robertgregor/wDuino/eagleFiles/wDuino.brd

## EAGLE design eagleFiles/wDuino.brd (2015-03-09)

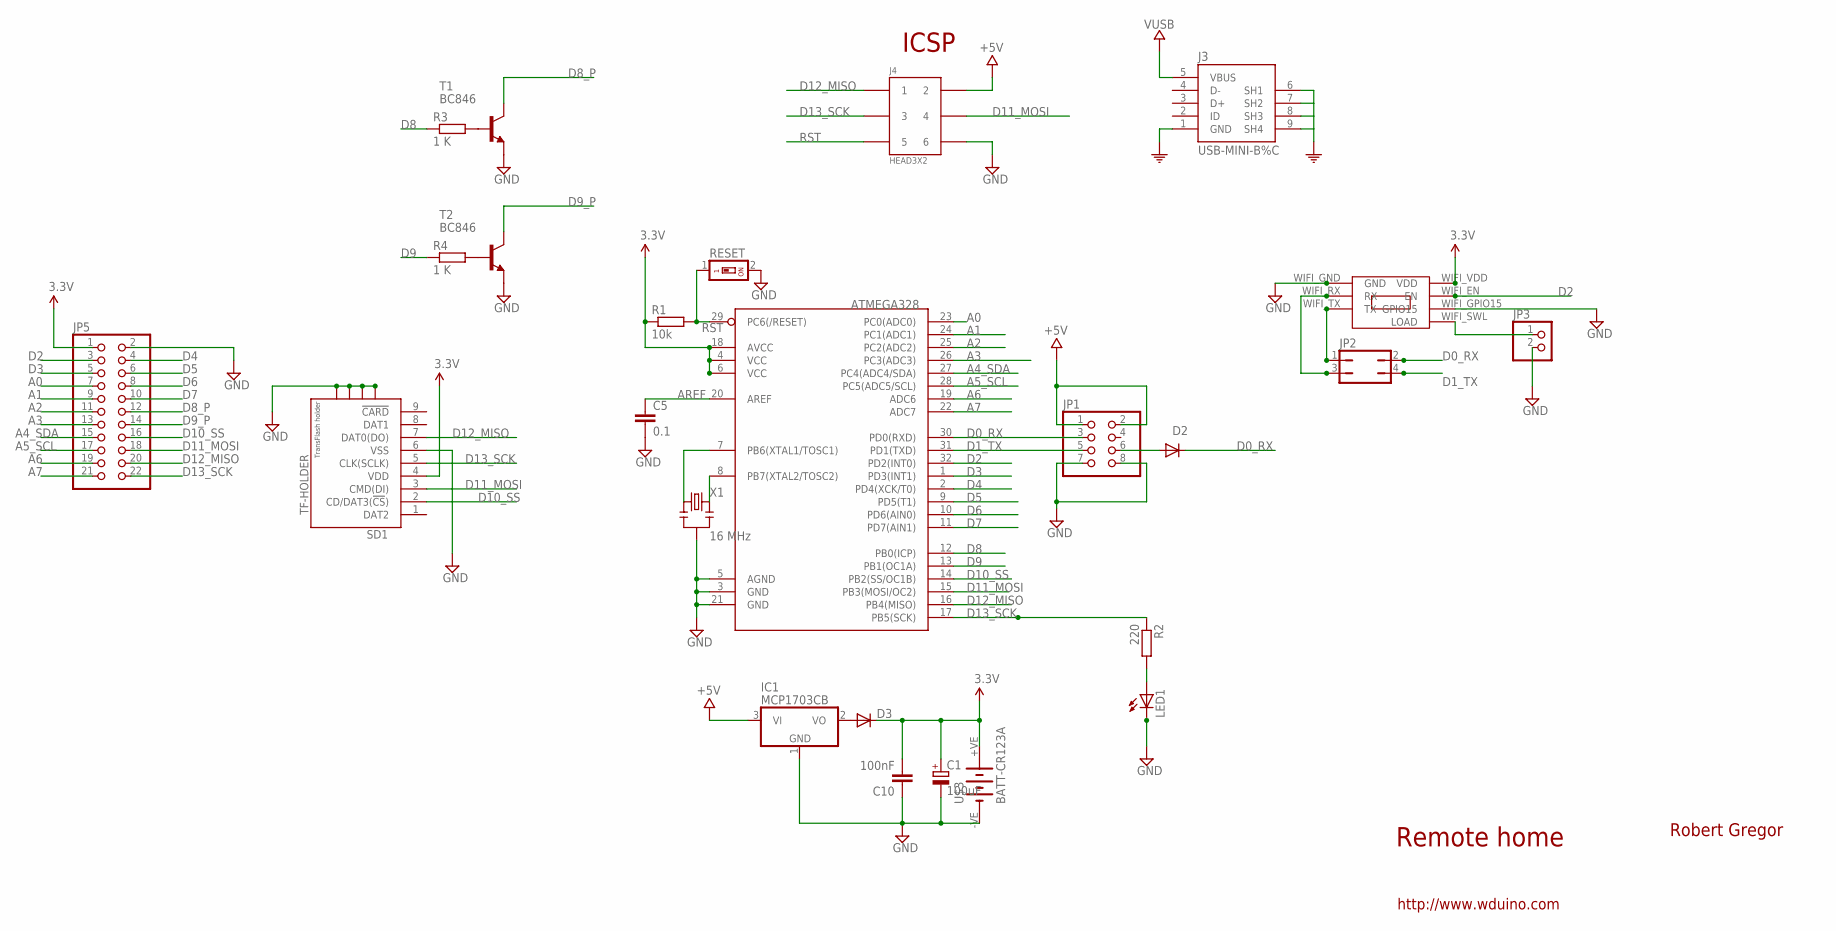
[picture p1: schematic wDuino.sch]

Parts:
ATMEGA328: ATMega-328; TQFP32-08
C1: 100uF; SMC_B
C5: 0.1; C0603
C10: 100nF; C0603
D2: DIODE-SOD123; SOD123
D3: DIODE-DO214AC; DO214AC
IC1: MCP1703CB; SOT23
J3: USB-MINI-B%C; USB-MINI-B_2
J4: HEAD3X2
JP1: PINHD-2X4; 2X04
JP2: JP2Q
JP3: PINHD-1X2; 1X02
JP5: PINHD-2X11; 2X11
LED1: LEDSML0603; SML0603
R1: 10k; R0603
R2: 220; R0603
R3, R4: 1 K; R0603
RESET: SWS001; SMS-001
SD1: TF-HOLDER; TF-PULL
T1, T2: BC846; SOT23
U$3: BATT-CR123A; KEYSTONE-2/3A
U$5: ESP03
X1: 16 MHz; RESONATOR-SMD

Connections:
5V: IC1.3 (VI), J3.5 (VBUS), J4.2, JP1.1, JP1.2
A0: ATMEGA328.23 (PC0(ADC0)), JP5.7
A1: ATMEGA328.24 (PC1(ADC1)), JP5.9
A2: ATMEGA328.25 (PC2(ADC2)), JP5.11
A3: ATMEGA328.26 (PC3(ADC3)), JP5.13
A4_SDA: ATMEGA328.27 (PC4(ADC4/SDA)), JP5.15
A5_SCL: ATMEGA328.28 (PC5(ADC5/SCL)), JP5.17
A6: ATMEGA328.19 (ADC6), JP5.19
A7: ATMEGA328.22 (ADC7), JP5.21
AREF: ATMEGA328.20 (AREF), C5.1
D0_RX: ATMEGA328.30 (PD0(RXD)), D2.C, JP1.3, JP2.2
D1_TX: ATMEGA328.31 (PD1(TXD)), JP1.5, JP2.4
D2: ATMEGA328.32 (PD2(INT0)), JP5.3, U$5.WIFI_EN (EN)
D3: ATMEGA328.1 (PD3(INT1)), JP5.5
D4: ATMEGA328.2 (PD4(XCK/T0)), JP5.4
D5: ATMEGA328.9 (PD5(T1)), JP5.6
D6: ATMEGA328.10 (PD6(AIN0)), JP5.8
D7: ATMEGA328.11 (PD7(AIN1)), JP5.10
D8: ATMEGA328.12 (PB0(ICP)), R3.1
D8_P: JP5.12, T1.3 (C)
D9: ATMEGA328.13 (PB1(OC1A)), R4.1
D9_P: JP5.14, T2.3 (C)
D10_SS: ATMEGA328.14 (PB2(SS/OC1B)), JP5.16, SD1.2 (CD/DAT3(!CS!))
D11_MOSI: ATMEGA328.15 (PB3(MOSI/OC2)), J4.4, JP5.18, SD1.3 (CMD(DI))
D12_MISO: ATMEGA328.16 (PB4(MISO)), J4.1, JP5.20, SD1.7 (DAT0(DO))
D13_SCK: ATMEGA328.17 (PB5(SCK)), J4.3, JP5.22, R2.1, SD1.5 (CLK(SCLK))
GND: ATMEGA328.3 (GND), ATMEGA328.5 (AGND), ATMEGA328.21 (GND), C1.-, C5.2, C10.1, IC1.1 (GND), J3.1 (GND), J3.6 (SH1), J3.7 (SH2), J3.8 (SH3), J3.9 (SH4), J4.6, JP1.7, JP1.8, JP3.2, JP5.2, LED1.C, RESET.2, SD1.6 (VSS), SD1.S1, SD1.S2, SD1.S3, SD1.S4, T1.2 (E), T2.2 (E), U$3.-VE (-), U$5.WIFI_GND (GND), U$5.WIFI_GPIO15 (GPIO15), X1.2
unnamed: ATMEGA328.7 (PB6(XTAL1/TOSC1)), X1.1
unnamed: D3.A, IC1.2 (VO)
unnamed: LED1.A, R2.2
unnamed: JP3.1, U$5.WIFI_SWL (LOAD)
unnamed: R4.2, T2.1 (B)
unnamed: D2.A, JP1.6
unnamed: R3.2, T1.1 (B)
unnamed: JP2.1, U$5.WIFI_TX (TX)
unnamed: JP2.3, U$5.WIFI_RX (RX)
unnamed: ATMEGA328.8 (PB7(XTAL2/TOSC2)), X1.3
RST: ATMEGA328.29 (PC6(/RESET)), J4.5, R1.2, RESET.1
VCC: ATMEGA328.4 (VCC), ATMEGA328.6 (VCC), ATMEGA328.18 (AVCC), C1.+, C10.2, D3.C, JP5.1, R1.1, SD1.4 (VDD), U$3.+VE (+), U$5.WIFI_VDD (VDD)

Notes on the sheet:
Remote home
Robert Gregor
http://www.wduino.com
ICSP

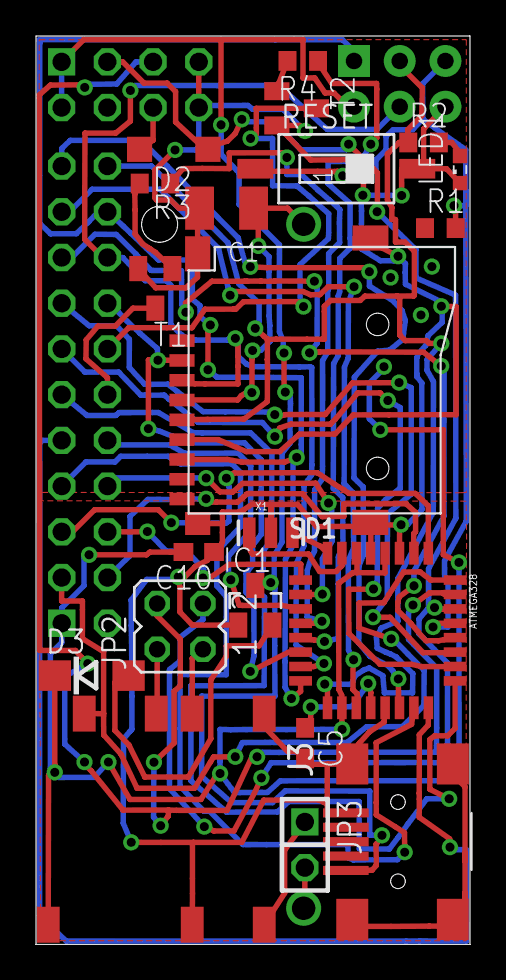
[picture p2: board eagleFiles/wDuino.brd from above]

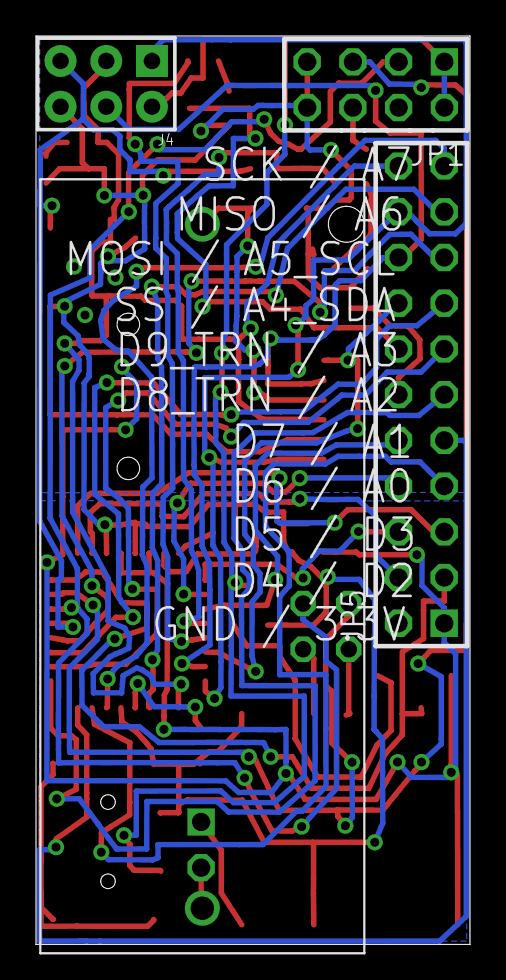
[picture p3: board eagleFiles/wDuino.brd from below]

Board: 2 copper layers, 24.1 x 50.5 mm, 25 parts (4 on the bottom side), 39 nets.
