robertgregor/wDuino/eagleFiles/itead/wDuino.brd

## EAGLE design eagleFiles/itead/wDuino.brd (2015-03-09)

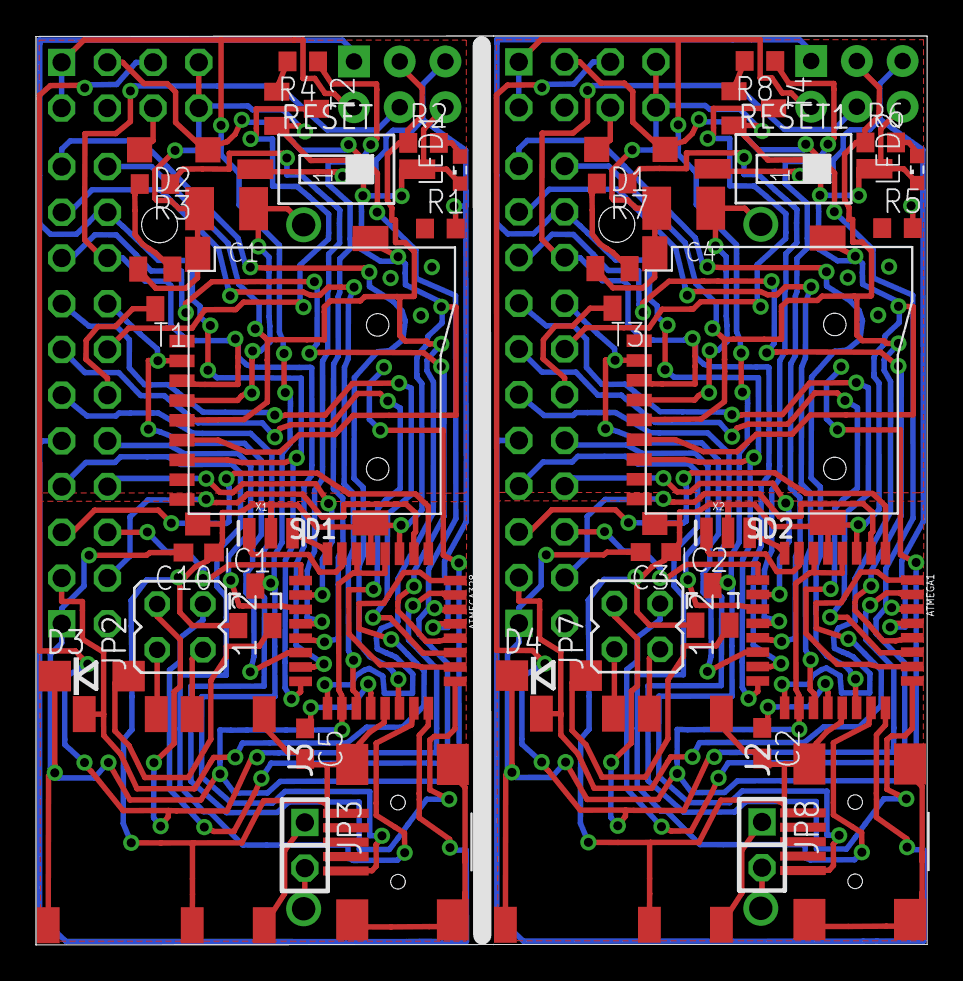
[picture p4: board eagleFiles/itead/wDuino.brd from above]

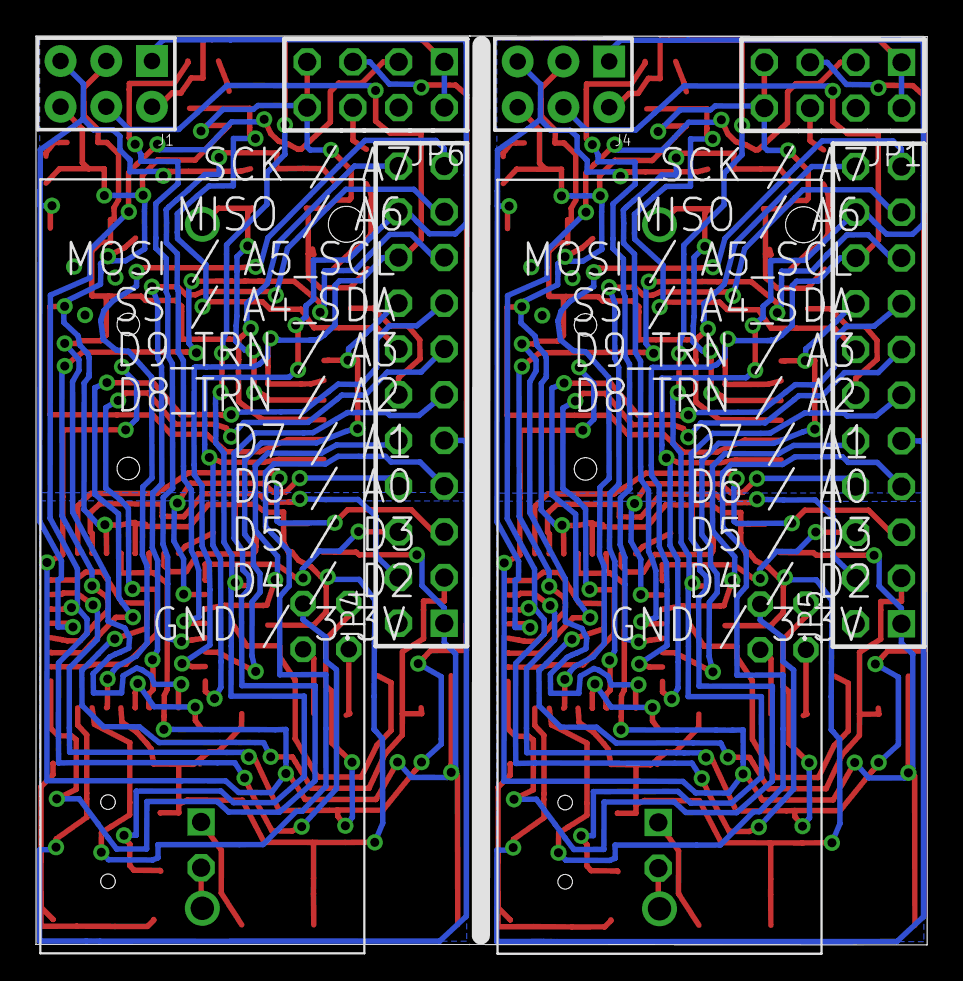
[picture p5: board eagleFiles/itead/wDuino.brd from below]

Board: 2 copper layers, 49.5 x 50.5 mm, 50 parts (8 on the bottom side), 78 nets.

Parts:
ATMEGA1, ATMEGA328: ATMega-328; TQFP32-08
C1, C4: 100uF; SMC_B
C2, C5: 0.1; C0603
C3, C10: 100nF; C0603
D1, D2: SOD123
D3, D4: DO214AC
IC1, IC2: MCP1703CB; SOT23
J1, J4: HEAD3X2
J2, J3: USB-MINI-B%C; USB-MINI-B_2
JP1, JP6: 2X04
JP2, JP7: JP2Q
JP3, JP8: 1X02
JP4, JP5: 2X11
LED1, LED2: SML0603
R1, R5: 10k; R0603
R2, R6: 220; R0603
R3, R4, R7, R8: 1 K; R0603
RESET, RESET1: SMS-001
SD1, SD2: TF-HOLDER; TF-PULL
T1, T2, T3, T4: BC846; SOT23
U$1, U$3: BATT-CR123A; KEYSTONE-2/3A
U$2, U$5: ESP03
X1, X2: 16 MHz; RESONATOR-SMD

Connections:
5V: IC1.3, J3.5, J4.2, JP1.1, JP1.2
5V1: IC2.3, J1.2, J2.5, JP6.1, JP6.2
A0: ATMEGA328.23, JP5.7
A1: ATMEGA328.24, JP5.9
A2: ATMEGA328.25, JP5.11
A3: ATMEGA328.26, JP5.13
A4: ATMEGA1.22, JP4.21
A4_SDA: ATMEGA328.27, JP5.15
A4_SDA1: ATMEGA1.27, JP4.15
A5: ATMEGA1.19, JP4.19
A5_SCL: ATMEGA328.28, JP5.17
A5_SCL1: ATMEGA1.28, JP4.17
A6: ATMEGA328.19, JP5.19
A7: ATMEGA328.22, JP5.21
A8: ATMEGA1.26, JP4.13
A9: ATMEGA1.25, JP4.11
A10: ATMEGA1.24, JP4.9
A11: ATMEGA1.23, JP4.7
AREF: ATMEGA328.20, C5.1
AREF1: ATMEGA1.20, C2.1
D0_RX: ATMEGA328.30, D2.C, JP1.3, JP2.2
D0_RX1: ATMEGA1.30, D1.C, JP6.3, JP7.2
D1: ATMEGA1.13, R8.1
D1_TX: ATMEGA328.31, JP1.5, JP2.4
D1_TX1: ATMEGA1.31, JP6.5, JP7.4
D2: ATMEGA328.32, JP5.3, U$5.WIFI_EN
D3: ATMEGA328.1, JP5.5
D4: ATMEGA328.2, JP5.4
D5: ATMEGA328.9, JP5.6
D6: ATMEGA328.10, JP5.8
D7: ATMEGA328.11, JP5.10
D8: ATMEGA328.12, R3.1
D8_P: JP5.12, T1.3
D8_P1: JP4.12, T3.3
D9: ATMEGA328.13, R4.1
D9_P: JP5.14, T2.3
D9_P1: JP4.14, T4.3
D10: ATMEGA1.12, R7.1
D10_SS: ATMEGA328.14, JP5.16, SD1.2
D10_SS1: ATMEGA1.14, JP4.16, SD2.2
D11: ATMEGA1.11, JP4.10
D11_MOSI: ATMEGA328.15, J4.4, JP5.18, SD1.3
D11_MOSI1: ATMEGA1.15, J1.4, JP4.18, SD2.3
D12: ATMEGA1.10, JP4.8
D12_MISO: ATMEGA328.16, J4.1, JP5.20, SD1.7
D12_MISO1: ATMEGA1.16, J1.1, JP4.20, SD2.7
D13: ATMEGA1.9, JP4.6
D13_SCK: ATMEGA328.17, J4.3, JP5.22, R2.1, SD1.5
D13_SCK1: ATMEGA1.17, J1.3, JP4.22, R6.1, SD2.5
D14: ATMEGA1.2, JP4.4
D15: ATMEGA1.1, JP4.5
D16: ATMEGA1.32, JP4.3, U$2.WIFI_EN
GND: ATMEGA328.3, ATMEGA328.5, ATMEGA328.21, C1.-, C5.2, C10.1, IC1.1, J3.1, J3.6, J3.7, J3.8, J3.9, J4.6, JP1.7, JP1.8, JP3.2, JP5.2, LED1.C, RESET.2, SD1.6, SD1.S1, SD1.S2, SD1.S3, SD1.S4, T1.2, T2.2, U$3.-VE, U$5.WIFI_GND, U$5.WIFI_GPIO15, X1.2
GND1: ATMEGA1.3, ATMEGA1.5, ATMEGA1.21, C2.2, C3.1, C4.-, IC2.1, J1.6, J2.1, J2.6, J2.7, J2.8, J2.9, JP4.2, JP6.7, JP6.8, JP8.2, LED2.C, RESET1.2, SD2.6, SD2.S1, SD2.S2, SD2.S3, SD2.S4, T3.2, T4.2, U$1.-VE, U$2.WIFI_GND, U$2.WIFI_GPIO15, X2.2
unnamed: ATMEGA328.7, X1.1
unnamed: D3.A, IC1.2
unnamed: ATMEGA1.7, X2.1
unnamed: LED1.A, R2.2
unnamed: JP3.1, U$5.WIFI_SWL
unnamed: R4.2, T2.1
unnamed: D2.A, JP1.6
unnamed: R3.2, T1.1
unnamed: ATMEGA1.8, X2.3
unnamed: JP2.1, U$5.WIFI_TX
unnamed: JP2.3, U$5.WIFI_RX
unnamed: JP7.1, U$2.WIFI_TX
unnamed: JP7.3, U$2.WIFI_RX
unnamed: LED2.A, R6.2
unnamed: D1.A, JP6.6
unnamed: R7.2, T3.1
unnamed: R8.2, T4.1
unnamed: D4.A, IC2.2
unnamed: JP8.1, U$2.WIFI_SWL
unnamed: ATMEGA328.8, X1.3
RST: ATMEGA328.29, J4.5, R1.2, RESET.1
RST1: ATMEGA1.29, J1.5, R5.2, RESET1.1
VCC: ATMEGA328.4, ATMEGA328.6, ATMEGA328.18, C1.+, C10.2, D3.C, JP5.1, R1.1, SD1.4, U$3.+VE, U$5.WIFI_VDD
VCC1: ATMEGA1.4, ATMEGA1.6, ATMEGA1.18, C3.2, C4.+, D4.C, JP4.1, R5.1, SD2.4, U$1.+VE, U$2.WIFI_VDD
