robertgregor/wDuino/(notices)

Notices in the files:
SketchLoader_Java/Java/src/main/java/org/remoteHome/stk500_v1/ConstantsStk500v1.java:
STK500ForJava is free software: you can redistribute it and/or modify
it under the terms of the GNU Lesser General Public License as published by
the Free Software Foundation, either version 3 of the License, or
(at your option) any later version.
parts and their libraries:
eagle-library-edeca.net-v5: This is v1 and is licensed under the Creative Commons (Attribution-Non-Commercial-Share Alike 2.0 UK)
